kabbi/led-cube-factory/docs/README.md

# the-better-cube docs

Generated by `make docs` from `build/` (run `make all model shapes` first); don't edit by hand.

## Boards

| | Board | LEDs | Pitch | DRC |
|---|---|---|---|---|
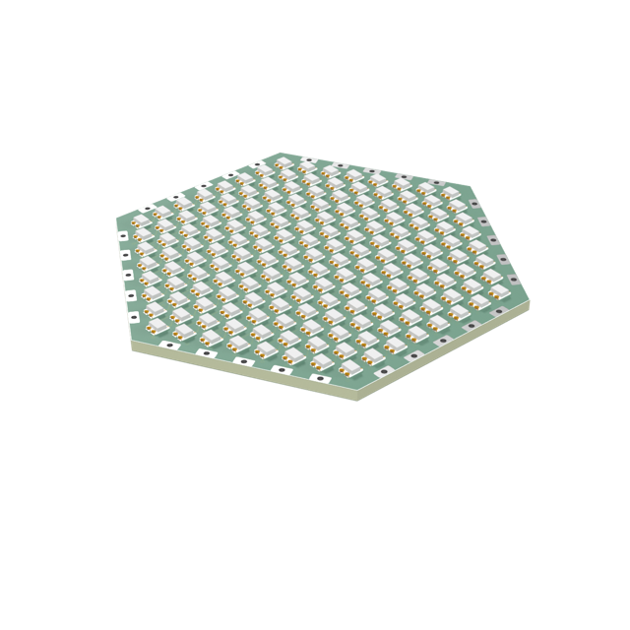
[picture p7: docs/boards/hex30-2020x169-p3.7-pvia/model.png]
|  | [hex30-2020x169-p3.7-pvia](boards/hex30-2020x169-p3.7-pvia/README.md) | 169 | 3.7 mm | 0 errors, 0 warnings, 0 unconnected |
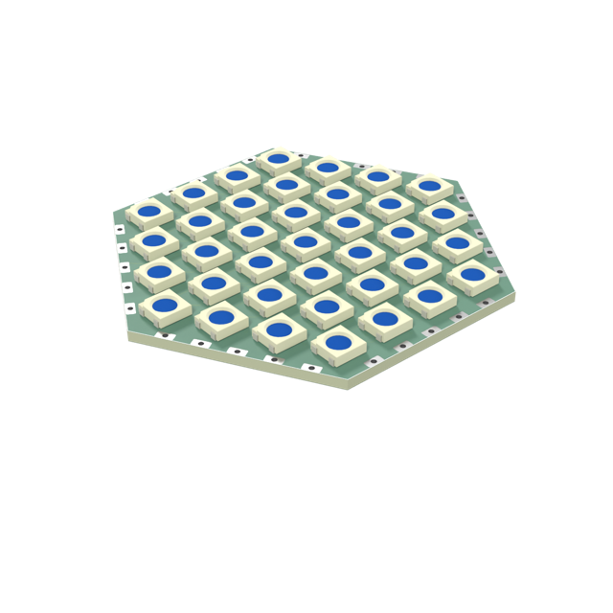
[picture p8: docs/boards/hex30-5050x37-p8-pvia/model.png]
|  | [hex30-5050x37-p8-pvia](boards/hex30-5050x37-p8-pvia/README.md) | 37 | 8 mm | 0 errors, 0 warnings, 0 unconnected |
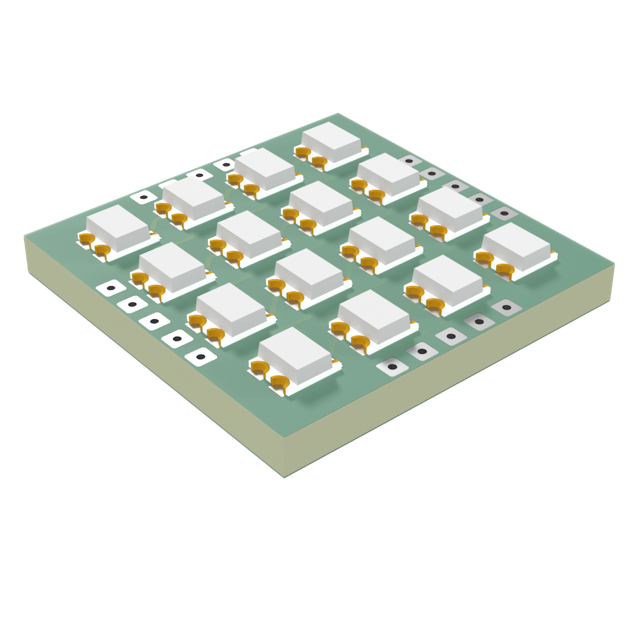
[picture p9: docs/boards/sq15-2020x16-p3.35-micro-pvia/model.png]
|  | [sq15-2020x16-p3.35-micro-pvia](boards/sq15-2020x16-p3.35-micro-pvia/README.md) | 16 | 3.35 mm | 0 errors, 0 warnings, 0 unconnected |
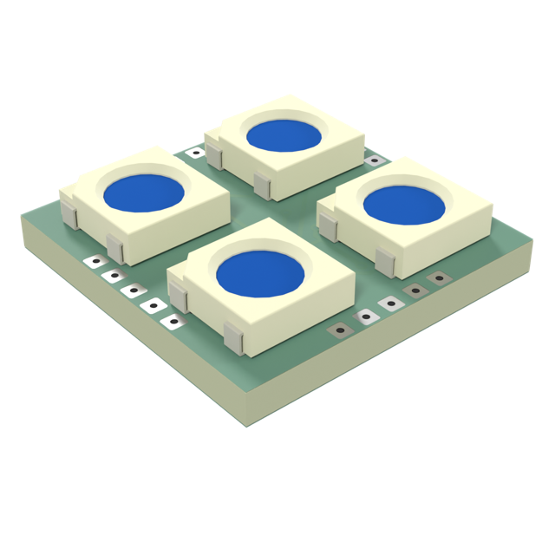
[picture p10: docs/boards/sq15-5050x4-p7.5-micro-pvia/model.png]
|  | [sq15-5050x4-p7.5-micro-pvia](boards/sq15-5050x4-p7.5-micro-pvia/README.md) | 4 | 7.5 mm | 0 errors, 0 warnings, 0 unconnected |
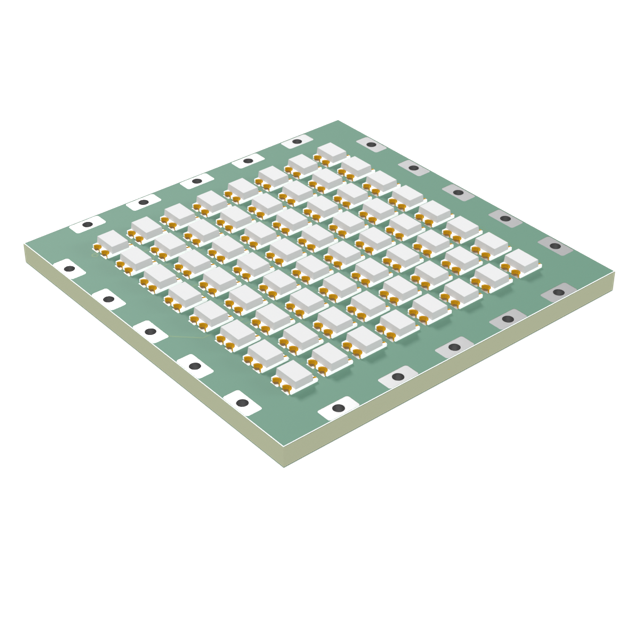
[picture p11: docs/boards/sq30-2020x64-p2.95-pvia/model.png]
|  | [sq30-2020x64-p2.95-pvia](boards/sq30-2020x64-p2.95-pvia/README.md) | 64 | 2.95 mm | 0 errors, 0 warnings, 0 unconnected |
|  | [sq30-2020x64-p3.4-tpl](boards/sq30-2020x64-p3.4-tpl/README.md) | 64 | 3.4 mm | 0 errors, 0 warnings, 0 unconnected |
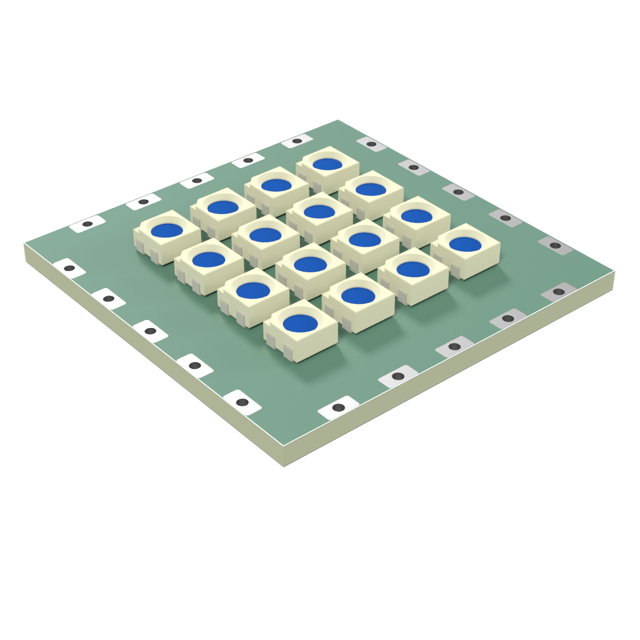
[picture p12: docs/boards/sq30-3535x16-p5-pvia/model.png]
|  | [sq30-3535x16-p5-pvia](boards/sq30-3535x16-p5-pvia/README.md) | 16 | 5 mm | 0 errors, 0 warnings, 0 unconnected |
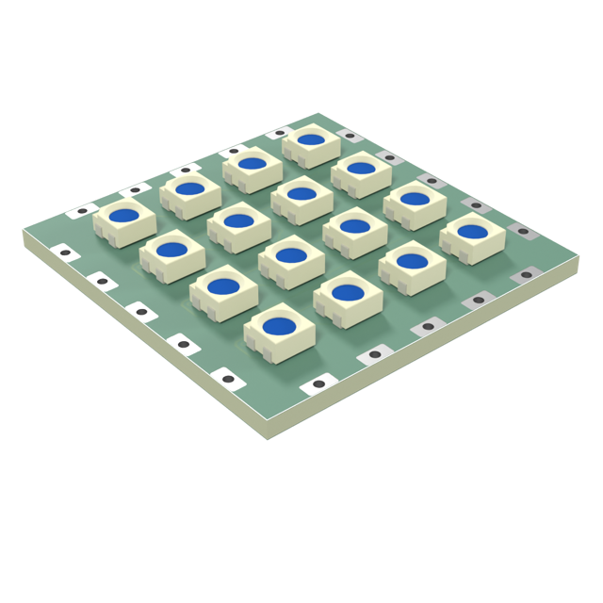
[picture p13: docs/boards/sq30-3535x16-p6.2-pvia/model.png]
|  | [sq30-3535x16-p6.2-pvia](boards/sq30-3535x16-p6.2-pvia/README.md) | 16 | 6.2 mm | 0 errors, 0 warnings, 0 unconnected |
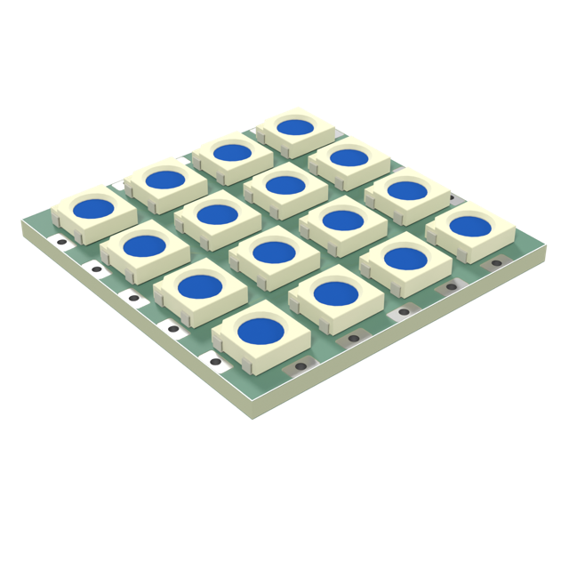
[picture p14: docs/boards/sq30-5050x16-p7.112-tpl/model.png]
|  | [sq30-5050x16-p7.112-tpl](boards/sq30-5050x16-p7.112-tpl/README.md) | 16 | 7.112 mm | 0 errors, 0 warnings, 0 unconnected |
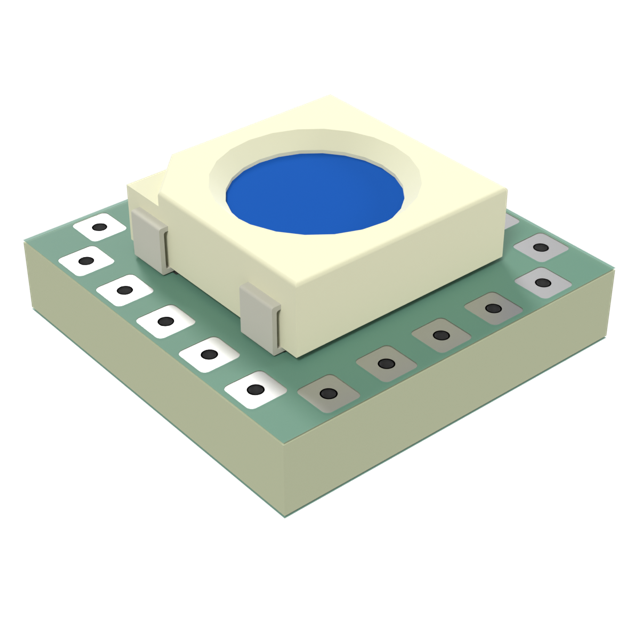
[picture p15: docs/boards/sq8-5050x1-p5.5-micro-grp-nopass-pvia/model.png]
|  | [sq8-5050x1-p5.5-micro-grp-nopass-pvia](boards/sq8-5050x1-p5.5-micro-grp-nopass-pvia/README.md) | 1 | 5.5 mm | 0 errors, 0 warnings, 0 unconnected |
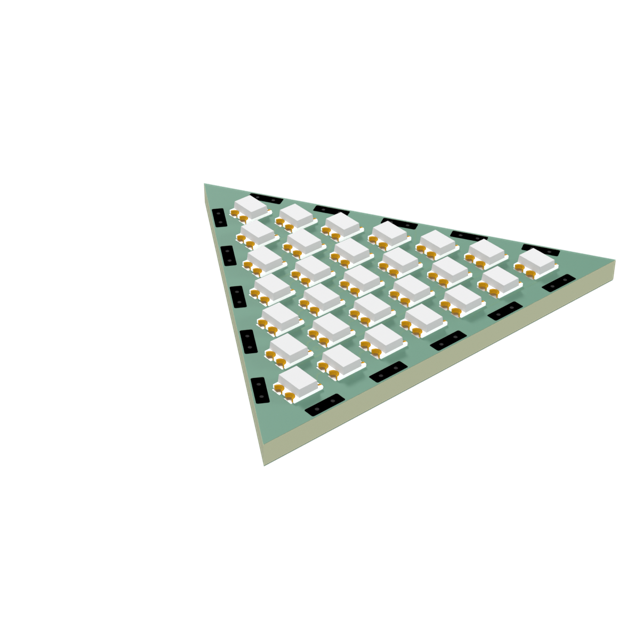
[picture p16: docs/boards/tri30-2020x28-p3.4-shallow-pvia/model.png]
|  | [tri30-2020x28-p3.4-shallow-pvia](boards/tri30-2020x28-p3.4-shallow-pvia/README.md) | 28 | 3.4 mm | 0 errors, 0 warnings, 0 unconnected |
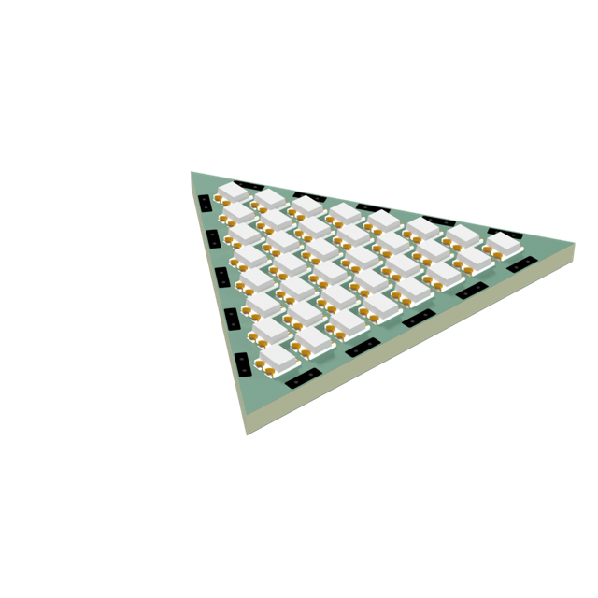
[picture p17: docs/boards/tri30-2020x36-p2.95-shallow-pvia/model.png]
|  | [tri30-2020x36-p2.95-shallow-pvia](boards/tri30-2020x36-p2.95-shallow-pvia/README.md) | 36 | 2.95 mm | 0 errors, 0 warnings, 0 unconnected |
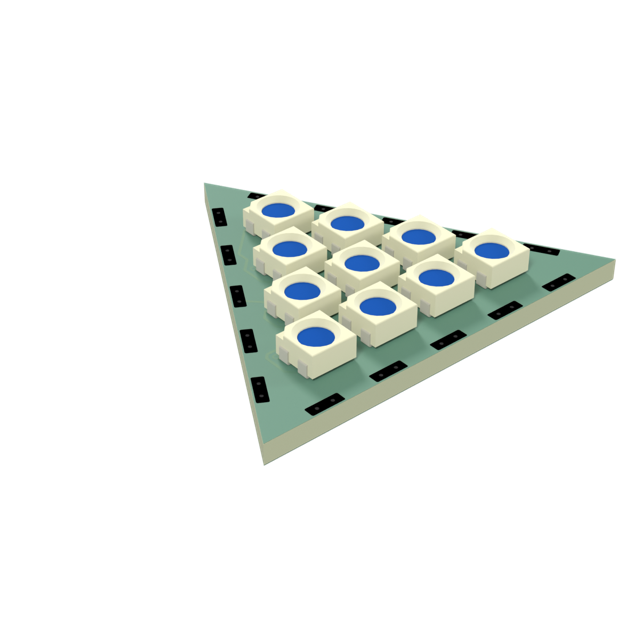
[picture p18: docs/boards/tri30-3535x10-p5-shallow-pvia/model.png]
|  | [tri30-3535x10-p5-shallow-pvia](boards/tri30-3535x10-p5-shallow-pvia/README.md) | 10 | 5 mm | 0 errors, 0 warnings, 0 unconnected |
|  | [tri30-3535x10-p6.2-shallow-rot](boards/tri30-3535x10-p6.2-shallow-rot/README.md) | 10 | 6.2 mm | 0 errors, 0 warnings, 0 unconnected |

## Shapes

| | Shape | LEDs |
|---|---|---|
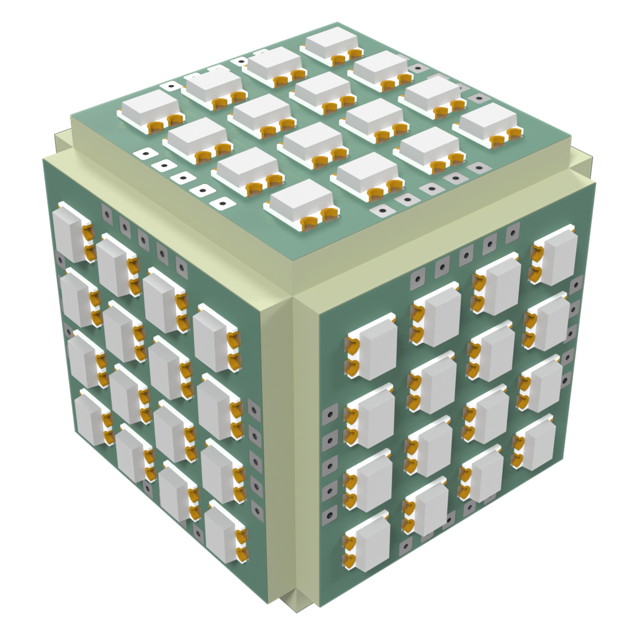
[picture p19: docs/shapes/cube--sq15-2020x16-p3.35-micro-pvia/render.png]
|  | [cube--sq15-2020x16-p3.35-micro-pvia](shapes/cube--sq15-2020x16-p3.35-micro-pvia/README.md) | 96 |
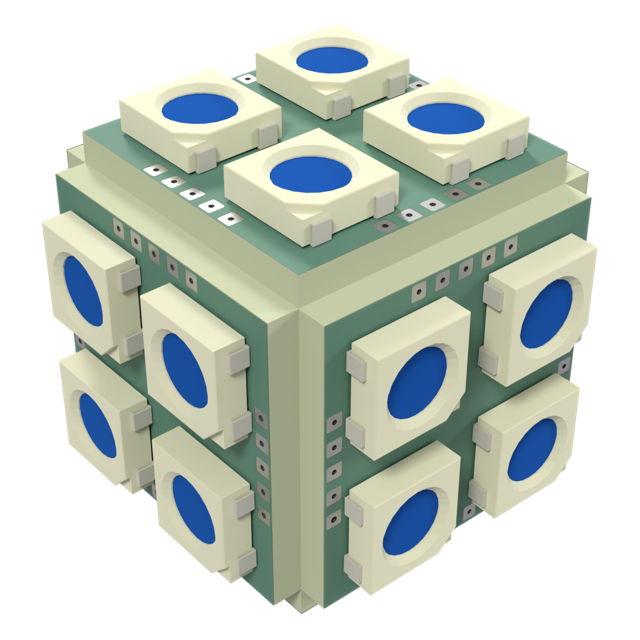
[picture p20: docs/shapes/cube--sq15-5050x4-p7.5-micro-pvia/render.png]
|  | [cube--sq15-5050x4-p7.5-micro-pvia](shapes/cube--sq15-5050x4-p7.5-micro-pvia/README.md) | 24 |
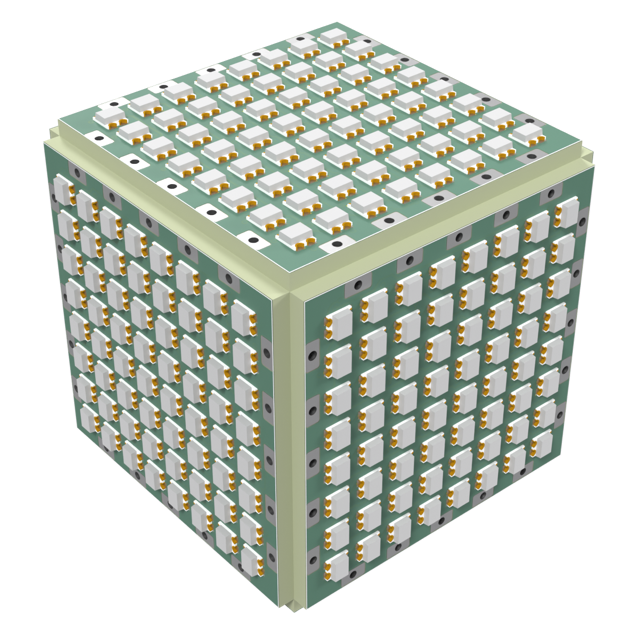
[picture p21: docs/shapes/cube--sq30-2020x64-p3.4-tpl/render.png]
|  | [cube--sq30-2020x64-p3.4-tpl](shapes/cube--sq30-2020x64-p3.4-tpl/README.md) | 384 |
|  | [cube--sq30-3535x16-p6.2-pvia](shapes/cube--sq30-3535x16-p6.2-pvia/README.md) | 96 |
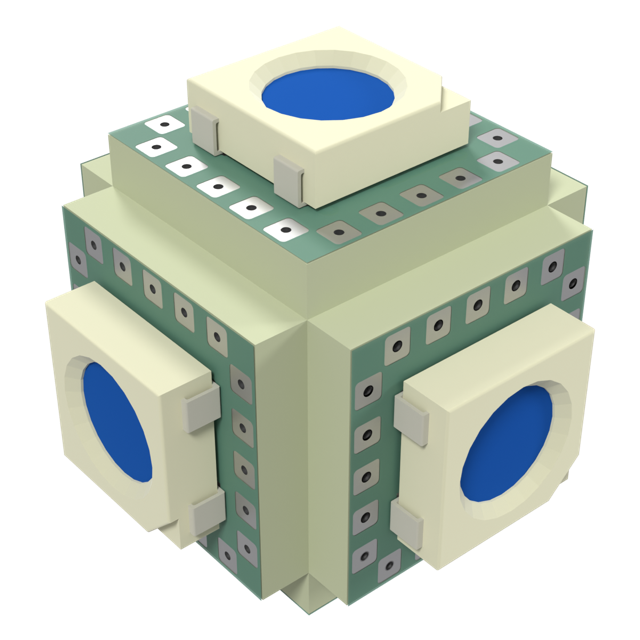
[picture p22: docs/shapes/cube--sq8-5050x1-p5.5-micro-grp-nopass-pvia/render.png]
|  | [cube--sq8-5050x1-p5.5-micro-grp-nopass-pvia](shapes/cube--sq8-5050x1-p5.5-micro-grp-nopass-pvia/README.md) | 6 |
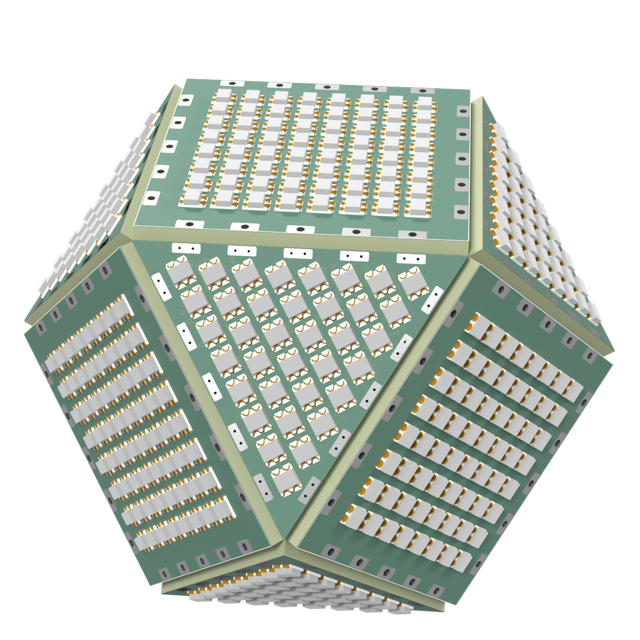
[picture p23: docs/shapes/cuboctahedron--sq30-2020x64-p2.95-pvia+tri30-2020x36-p2.95-shallow-pvia/render.png]
|  | [cuboctahedron--sq30-2020x64-p2.95-pvia+tri30-2020x36-p2.95-shallow-pvia](shapes/cuboctahedron--sq30-2020x64-p2.95-pvia+tri30-2020x36-p2.95-shallow-pvia/README.md) | 672 |
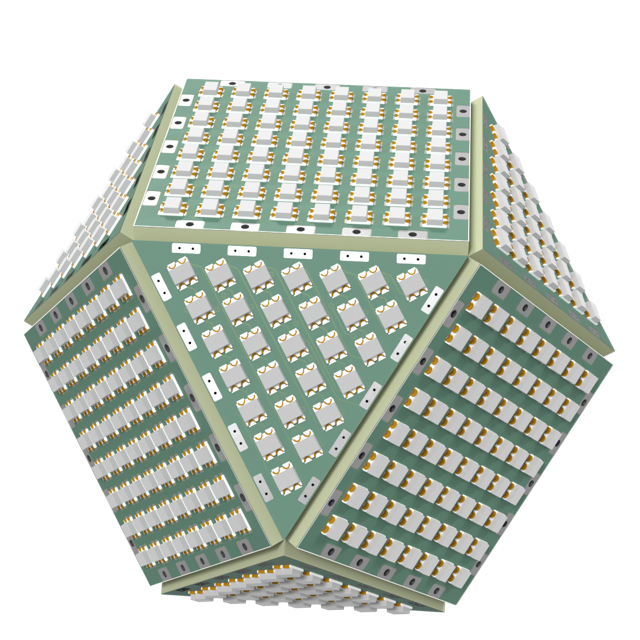
[picture p24: docs/shapes/cuboctahedron--sq30-2020x64-p3.4-tpl+tri30-2020x28-p3.4-shallow-pvia/render.png]
|  | [cuboctahedron--sq30-2020x64-p3.4-tpl+tri30-2020x28-p3.4-shallow-pvia](shapes/cuboctahedron--sq30-2020x64-p3.4-tpl+tri30-2020x28-p3.4-shallow-pvia/README.md) | 608 |
|  | [cuboctahedron--sq30-3535x16-p6.2-pvia+tri30-3535x10-p6.2-shallow-rot](shapes/cuboctahedron--sq30-3535x16-p6.2-pvia+tri30-3535x10-p6.2-shallow-rot/README.md) | 176 |
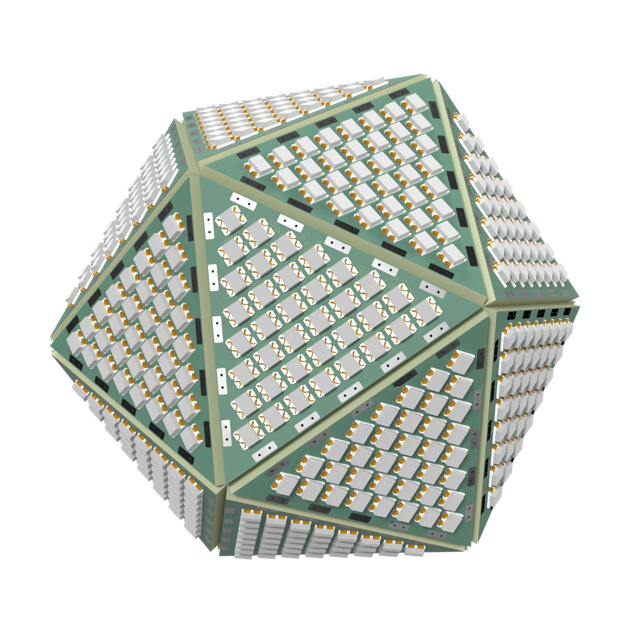
[picture p25: docs/shapes/icosahedron--tri30-2020x36-p2.95-shallow-pvia/render.png]
|  | [icosahedron--tri30-2020x36-p2.95-shallow-pvia](shapes/icosahedron--tri30-2020x36-p2.95-shallow-pvia/README.md) | 720 |
|  | [icosahedron--tri30-3535x10-p6.2-shallow-rot](shapes/icosahedron--tri30-3535x10-p6.2-shallow-rot/README.md) | 200 |
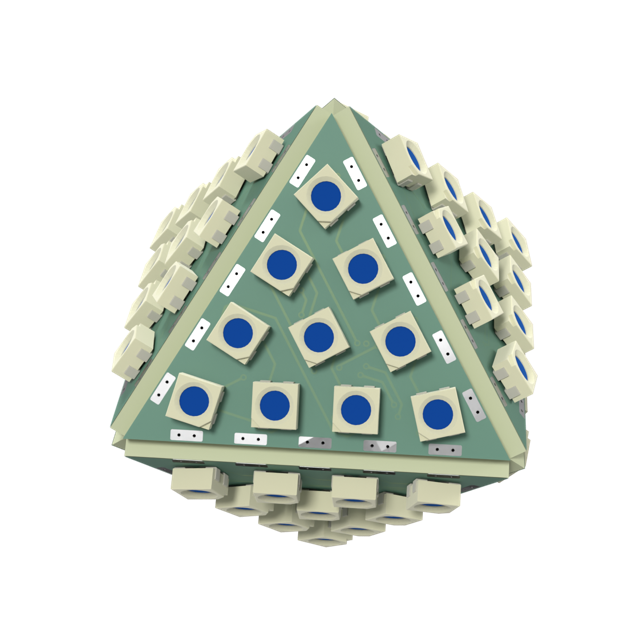
[picture p26: docs/shapes/octahedron--tri30-3535x10-p6.2-shallow-rot/render.png]
|  | [octahedron--tri30-3535x10-p6.2-shallow-rot](shapes/octahedron--tri30-3535x10-p6.2-shallow-rot/README.md) | 80 |
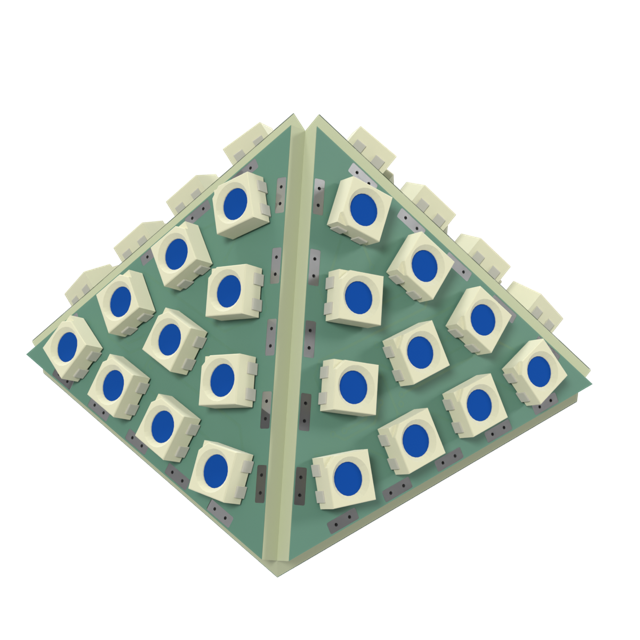
[picture p27: docs/shapes/square-pyramid--sq30-3535x16-p6.2-pvia+tri30-3535x10-p6.2-shallow-rot/render.png]
|  | [square-pyramid--sq30-3535x16-p6.2-pvia+tri30-3535x10-p6.2-shallow-rot](shapes/square-pyramid--sq30-3535x16-p6.2-pvia+tri30-3535x10-p6.2-shallow-rot/README.md) | 56 |
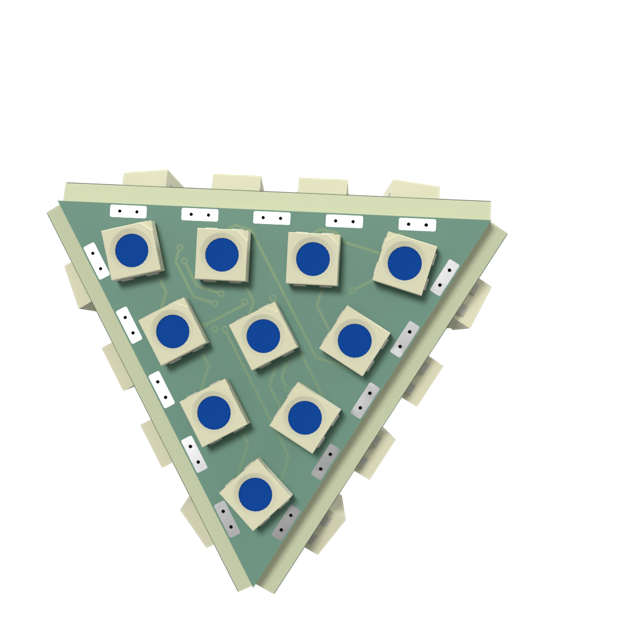
[picture p28: docs/shapes/tetrahedron--tri30-3535x10-p6.2-shallow-rot/render.png]
|  | [tetrahedron--tri30-3535x10-p6.2-shallow-rot](shapes/tetrahedron--tri30-3535x10-p6.2-shallow-rot/README.md) | 40 |
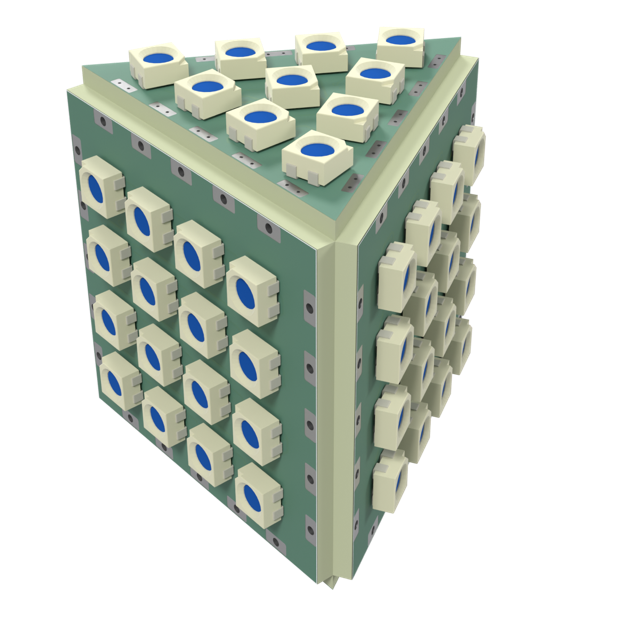
[picture p29: docs/shapes/triangular-prism--sq30-3535x16-p6.2-pvia+tri30-3535x10-p6.2-shallow-rot/render.png]
|  | [triangular-prism--sq30-3535x16-p6.2-pvia+tri30-3535x10-p6.2-shallow-rot](shapes/triangular-prism--sq30-3535x16-p6.2-pvia+tri30-3535x10-p6.2-shallow-rot/README.md) | 68 |
|  | [truncated-octahedron--sq30-2020x64-p3.4-tpl+hex30-2020x169-p3.7-pvia](shapes/truncated-octahedron--sq30-2020x64-p3.4-tpl+hex30-2020x169-p3.7-pvia/README.md) | 1736 |
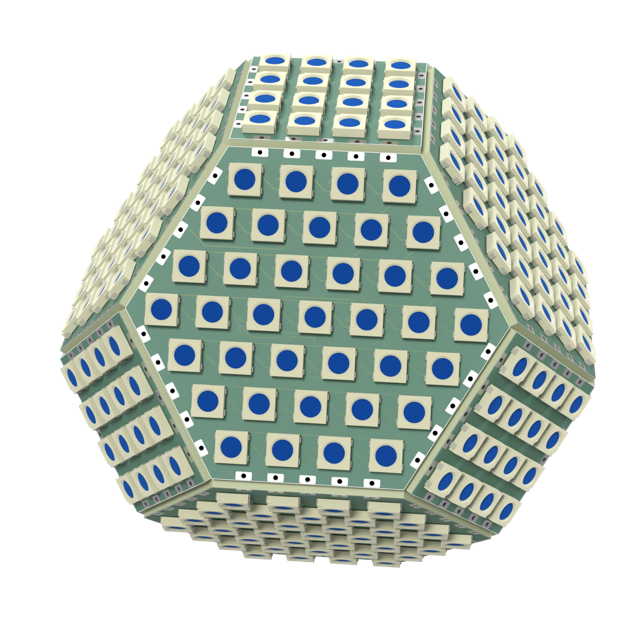
[picture p30: docs/shapes/truncated-octahedron--sq30-5050x16-p7.112-tpl+hex30-5050x37-p8-pvia/render.png]
|  | [truncated-octahedron--sq30-5050x16-p7.112-tpl+hex30-5050x37-p8-pvia](shapes/truncated-octahedron--sq30-5050x16-p7.112-tpl+hex30-5050x37-p8-pvia/README.md) | 392 |
