kabbi/led-cube-factory/docs/boards/sq15-5050x4-p7.5-micro-pvia/README.md

# sq15-5050x4-p7.5-micro-pvia

2x2 WS2812B 5050 on a 15mm square at 7.5mm pitch, half the edge, so the LED grid stays even across tile edges; the widest that keeps the LED bodies 0.3mm from the micro edge connector's pads. (5.5mm, courtyards touching, fits a 13mm edge.)

3D render

## At a glance

| | |
|---|---|
| Shape | square, 15 mm edge, 4 ports |
| LEDs | 4 x WS2812B (2 x 2) |
| Footprint | `tbc:LED_WS2812B_PLCC4_5.0x5.0mm_InnerPads` |
| LCSC | C52917433 |
| Pitch | 7.5 mm |
| Rotation | one rotation, DOUT to the right |
| Chain | raster |
| Edge connector | `edge_connector_micro` (`tbc:edge_conn_micro`) |
| Back side | generated: IN/OUT/PASS jumper hubs with 4 wings each (1.6 mm from the hub centre, hubs on a 3.0 mm circle), 1 cap on P2 |
| Power vias | pattern |
| Router | internal |
| Revision | A |

## Name

| | |
|---|---|
| `sq15` | square, 15 mm edge |
| `5050x4` | 4 LEDs in the 5050 package |
| `p7.5` | 7.5 mm LED pitch |
| `micro` | micro edge connector (small tiles) |
| `pvia` | patterned power vias |

## Build

| | |
|---|---|
| DRC | 0 errors, 0 warnings, 0 unconnected |
| Front track | 52 mm |
| Back track | 58 mm |
| In2 hops | 0 mm |
| Vias | 17 |

## Renders

| Top | Bottom |
|---|---|
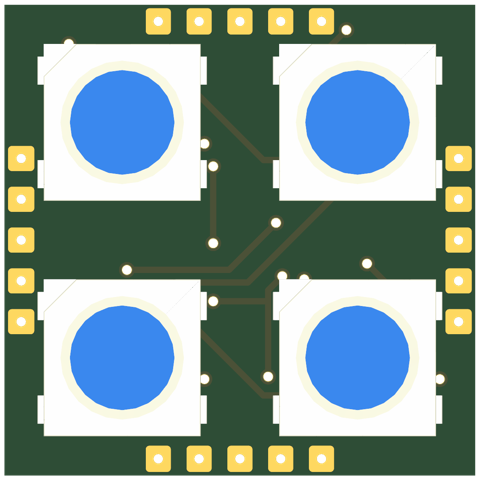
[picture p33: docs/boards/sq15-5050x4-p7.5-micro-pvia/top.png]
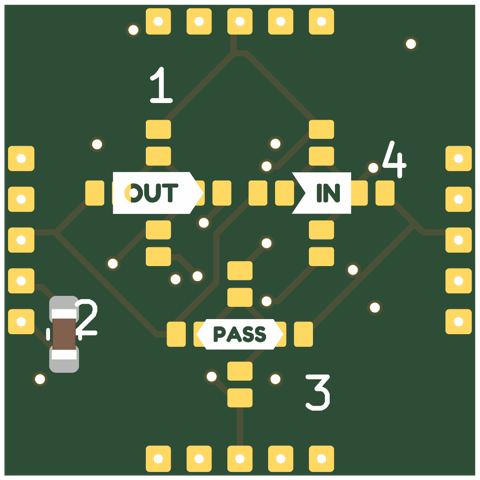
[picture p34: docs/boards/sq15-5050x4-p7.5-micro-pvia/bottom.png]
|  |  |

### Layers

| Front: F.Cu, silkscreen | Back, seen from below: B.Cu, silkscreen |
|---|---|
|  |  |

| In1: GND plane | In2: +5V plane (and a few hops) |
|---|---|
|  |  |

## Pixel map

LED index in the data chain -> position, mm from the board centre (y down, top view). Also in [pixelmap.json](pixelmap.json).

<details><summary>4 LEDs, 4 ports</summary>

| LED | x | y |
|---|---|---|
| 1 | -3.75 | -3.75 |
| 2 | 3.75 | -3.75 |
| 3 | -3.75 | 3.75 |
| 4 | 3.75 | 3.75 |

| Port | x | y | facing |
|---|---|---|---|
| P1 | 0.00 | -7.50 | -90 deg |
| P2 | 7.50 | 0.00 | 0 deg |
| P3 | 0.00 | 7.50 | 90 deg |
| P4 | -7.50 | 0.00 | 180 deg |

</details>

## Used in

- [cube--sq15-5050x4-p7.5-micro-pvia](../../shapes/cube--sq15-5050x4-p7.5-micro-pvia/README.md)

## Files

- config: [boards/sq15-5050x4-p7.5-micro-pvia.yaml](../../../boards/sq15-5050x4-p7.5-micro-pvia.yaml)
- rebuild: `make all model BOARDS=sq15-5050x4-p7.5-micro-pvia && make docs`
- KiCad project, gerbers, BOM/CPL: `build/sq15-5050x4-p7.5-micro-pvia/` (not committed)
