kabbi/led-cube-factory/docs/shapes/cube--sq15-2020x16-p3.35-micro-pvia/README.md

# cube--sq15-2020x16-p3.35-micro-pvia

The small 2020 cube: six 15mm tiles, 4x4 WS2812B-2020 each, 96 LEDs.

render

| | |
|---|---|
| Solid | cube, 6 faces |
| Tiles | 6 x square |
| LEDs | 96 (6 x 16) |
| Size | 20 x 20 x 20 mm (with LEDs) |

## Boards

- **6 x [sq15-2020x16-p3.35-micro-pvia](../../boards/sq15-2020x16-p3.35-micro-pvia/README.md)**: 16 x WS2812B-2020 at 3.35 mm

## Files

- config: [shapes/cube--sq15-2020x16-p3.35-micro-pvia.yaml](../../../shapes/cube--sq15-2020x16-p3.35-micro-pvia.yaml)
- rebuild: `make shapes SHAPES=cube--sq15-2020x16-p3.35-micro-pvia && make docs`
- 3D model: `build/shapes/cube--sq15-2020x16-p3.35-micro-pvia.glb` (not committed; opens in Blender or any glTF viewer)
