kabbi/led-cube-factory/docs/shapes/cube--sq15-5050x4-p7.5-micro-pvia/README.md

# cube--sq15-5050x4-p7.5-micro-pvia

The small 5050 cube: six 15mm tiles, 2x2 WS2812B each, 24 LEDs.

render

| | |
|---|---|
| Solid | cube, 6 faces |
| Tiles | 6 x square |
| LEDs | 24 (6 x 4) |
| Size | 21 x 21 x 21 mm (with LEDs) |

## Boards

- **6 x [sq15-5050x4-p7.5-micro-pvia](../../boards/sq15-5050x4-p7.5-micro-pvia/README.md)**: 4 x WS2812B at 7.5 mm

## Files

- config: [shapes/cube--sq15-5050x4-p7.5-micro-pvia.yaml](../../../shapes/cube--sq15-5050x4-p7.5-micro-pvia.yaml)
- rebuild: `make shapes SHAPES=cube--sq15-5050x4-p7.5-micro-pvia && make docs`
- 3D model: `build/shapes/cube--sq15-5050x4-p7.5-micro-pvia.glb` (not committed; opens in Blender or any glTF viewer)
