kabbi/led-cube-factory/docs/boards/sq15-5050x4-p5.5-micro-pvia/README.md

# sq15-5050x4-p5.5-micro-pvia

2x2 WS2812B 5050 at 5.5mm pitch (courtyards touching) on a 15mm square, with the micro edge connector like the other small tiles. Fits 13mm (the LED bodies 0.3mm from the connector pads); 15mm to match the 4x4 2020.

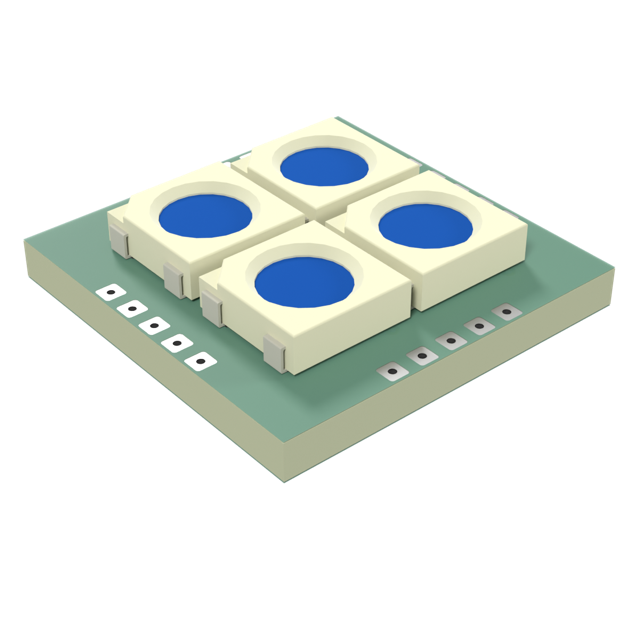
[picture p38: docs/boards/sq15-5050x4-p5.5-micro-pvia/model.png]
3D render


## At a glance

| | |
|---|---|
| Shape | square, 15 mm edge, 4 ports |
| LEDs | 4 x WS2812B (2 x 2) |
| Footprint | `tbc:LED_WS2812B_PLCC4_5.0x5.0mm_InnerPads` |
| LCSC | C52917433 |
| Pitch | 5.5 mm |
| Rotation | one rotation, DOUT to the right |
| Chain | raster |
| Edge connector | `edge_connector_micro` (`tbc:edge_conn_micro`) |
| Back side | generated: IN/OUT/PASS jumper hubs with 4 wings each (1.6 mm from the hub centre, hubs on a 3.0 mm circle), 1 cap on P2 |
| Power vias | pattern |
| Router | internal |
| Revision | A |

## Name

| | |
|---|---|
| `sq15` | square, 15 mm edge |
| `5050x4` | 4 LEDs in the 5050 package |
| `p5.5` | 5.5 mm LED pitch |
| `micro` | micro edge connector (small tiles) |
| `pvia` | patterned power vias |

## Build

| | |
|---|---|
| DRC | 0 errors, 0 warnings, 0 unconnected |
| Front track | 44 mm |
| Back track | 66 mm |
| In2 hops | 0 mm |
| Vias | 18 |

## Renders

| Top | Bottom |
|---|---|
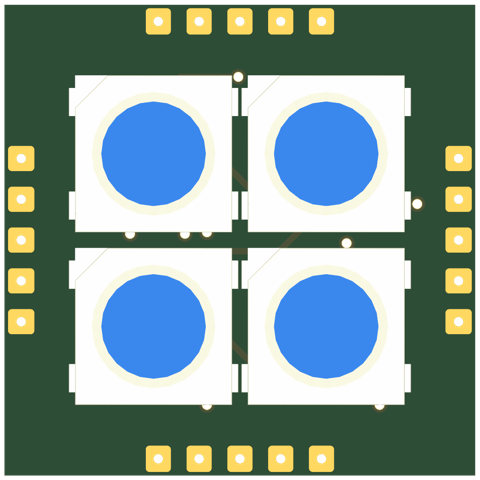
[picture p39: docs/boards/sq15-5050x4-p5.5-micro-pvia/top.png]
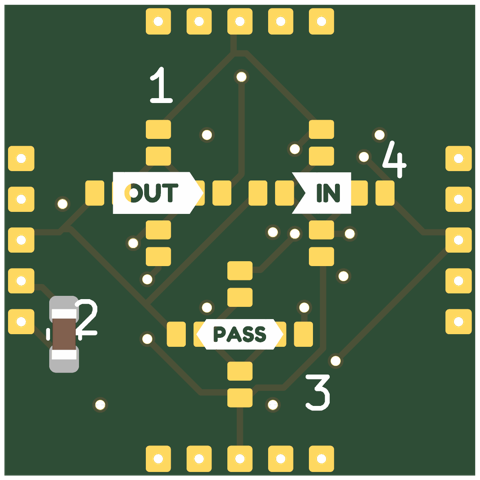
[picture p40: docs/boards/sq15-5050x4-p5.5-micro-pvia/bottom.png]
|  |  |

### Layers

| Front: F.Cu, silkscreen | Back, seen from below: B.Cu, silkscreen |
|---|---|
|  |  |

| In1: GND plane | In2: +5V plane (and a few hops) |
|---|---|
|  |  |

## Pixel map

LED index in the data chain -> position, mm from the board centre (y down, top view). Also in [pixelmap.json](pixelmap.json).

<details><summary>4 LEDs, 4 ports</summary>

| LED | x | y |
|---|---|---|
| 1 | -2.75 | -2.75 |
| 2 | 2.75 | -2.75 |
| 3 | -2.75 | 2.75 |
| 4 | 2.75 | 2.75 |

| Port | x | y | facing |
|---|---|---|---|
| P1 | 0.00 | -7.50 | -90 deg |
| P2 | 7.50 | 0.00 | 0 deg |
| P3 | 0.00 | 7.50 | 90 deg |
| P4 | -7.50 | 0.00 | 180 deg |

</details>

## Used in

- [cube--sq15-5050x4-p5.5-micro-pvia](../../shapes/cube--sq15-5050x4-p5.5-micro-pvia/README.md)

## Files

- config: [boards/sq15-5050x4-p5.5-micro-pvia.yaml](../../../boards/sq15-5050x4-p5.5-micro-pvia.yaml)
- rebuild: `make all model BOARDS=sq15-5050x4-p5.5-micro-pvia && make docs`
- KiCad project, gerbers, BOM/CPL: `build/sq15-5050x4-p5.5-micro-pvia/` (not committed)
