kabbi/led-cube-factory/docs/shapes/cube--sq8-5050x1-p5.5-micro-grp-nopass-pvia/README.md

# cube--sq8-5050x1-p5.5-micro-grp-nopass-pvia

The 6-LED cube: six 8mm micro tiles, one WS2812B each, IN/OUT jumpers only.

render

| | |
|---|---|
| Solid | cube, 6 faces |
| Tiles | 6 x square |
| LEDs | 6 (6 x 1) |
| Size | 14 x 14 x 14 mm (with LEDs) |

## Boards

- **6 x [sq8-5050x1-p5.5-micro-grp-nopass-pvia](../../boards/sq8-5050x1-p5.5-micro-grp-nopass-pvia/README.md)**: 1 x WS2812B at 5.5 mm

## Files

- config: [shapes/cube--sq8-5050x1-p5.5-micro-grp-nopass-pvia.yaml](../../../shapes/cube--sq8-5050x1-p5.5-micro-grp-nopass-pvia.yaml)
- rebuild: `make shapes SHAPES=cube--sq8-5050x1-p5.5-micro-grp-nopass-pvia && make docs`
- 3D model: `build/shapes/cube--sq8-5050x1-p5.5-micro-grp-nopass-pvia.glb` (not committed; opens in Blender or any glTF viewer)
