kabbi/led-cube-factory/docs/boards/hex30-2020x169-p3.7-pvia/README.md

# hex30-2020x169-p3.7-pvia

Hexagon tile, 8 rings (169) of WS2812B-2020 at 3.7mm pitch: the LED density of the 8x8 sq30-2020x64-p3.4-tpl (0.072/mm2), and 3.7mm is about the widest 8 rings go (0.6mm from the pads to the connector pads; 3.75 leaves 0.3). 9 rings (217) would need 3.3mm and doesn't route: six ports to three hubs take In2 crossings, and a 3.3-3.4mm field has no room for their vias.

3D render

## At a glance

| | |
|---|---|
| Shape | hexagon, 30 mm edge, 6 ports |
| LEDs | 169 x WS2812B-2020 (8 rings) |
| Footprint | `tbc:LED_WS2812B-2020_PLCC4_2.0x2.0mm` |
| LCSC | C52917434 |
| Pitch | 3.7 mm |
| Rotation | one rotation, DOUT to the right |
| Chain | raster |
| Edge connector | `edge_connector` (`tbc:edge_conn`) |
| Back side | generated: IN/OUT/PASS jumper hubs with 6 wings each (4.3 mm from the hub centre, hubs on a 8.0 mm circle), 2 caps per edge |
| Power vias | pattern |
| Router | internal |
| Revision | A |

## Name

| | |
|---|---|
| `hex30` | hexagon, 30 mm edge |
| `2020x169` | 169 LEDs in the 2020 package |
| `p3.7` | 3.7 mm LED pitch |
| `pvia` | patterned power vias |

## Build

| | |
|---|---|
| DRC | 0 errors, 0 warnings, 0 unconnected |
| Front track | 1223 mm |
| Back track | 409 mm |
| In2 hops | 13.7 mm |
| Vias | 369 |

## Renders

| Top | Bottom |
|---|---|
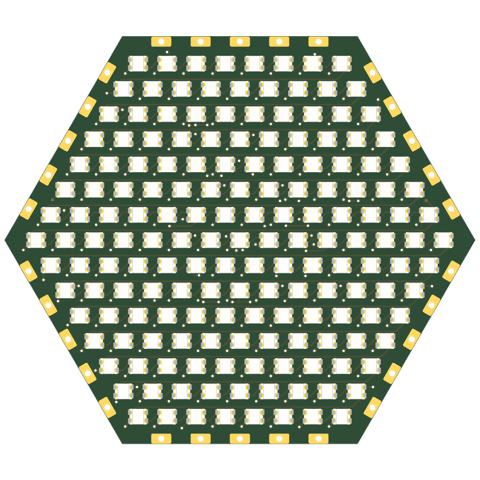
[picture p43: docs/boards/hex30-2020x169-p3.7-pvia/top.png]
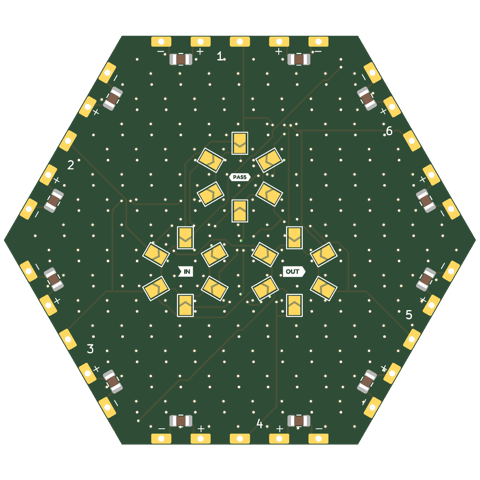
[picture p44: docs/boards/hex30-2020x169-p3.7-pvia/bottom.png]
|  |  |

### Layers

| Front: F.Cu, silkscreen | Back, seen from below: B.Cu, silkscreen |
|---|---|
|  |  |

| In1: GND plane | In2: +5V plane (and a few hops) |
|---|---|
|  |  |

## Pixel map

LED index in the data chain -> position, mm from the board centre (y down, top view). Also in [pixelmap.json](pixelmap.json).

<details><summary>169 LEDs, 6 ports</summary>

| LED | x | y |
|---|---|---|
| 1 | -12.95 | -22.43 |
| 2 | -9.25 | -22.43 |
| 3 | -5.55 | -22.43 |
| 4 | -1.85 | -22.43 |
| 5 | 1.85 | -22.43 |
| 6 | 5.55 | -22.43 |
| 7 | 9.25 | -22.43 |
| 8 | 12.95 | -22.43 |
| 9 | -14.80 | -19.23 |
| 10 | -11.10 | -19.23 |
| 11 | -7.40 | -19.23 |
| 12 | -3.70 | -19.23 |
| 13 | 0.00 | -19.23 |
| 14 | 3.70 | -19.23 |
| 15 | 7.40 | -19.23 |
| 16 | 11.10 | -19.23 |
| 17 | 14.80 | -19.23 |
| 18 | -16.65 | -16.02 |
| 19 | -12.95 | -16.02 |
| 20 | -9.25 | -16.02 |
| 21 | -5.55 | -16.02 |
| 22 | -1.85 | -16.02 |
| 23 | 1.85 | -16.02 |
| 24 | 5.55 | -16.02 |
| 25 | 9.25 | -16.02 |
| 26 | 12.95 | -16.02 |
| 27 | 16.65 | -16.02 |
| 28 | -18.50 | -12.82 |
| 29 | -14.80 | -12.82 |
| 30 | -11.10 | -12.82 |
| 31 | -7.40 | -12.82 |
| 32 | -3.70 | -12.82 |
| 33 | 0.00 | -12.82 |
| 34 | 3.70 | -12.82 |
| 35 | 7.40 | -12.82 |
| 36 | 11.10 | -12.82 |
| 37 | 14.80 | -12.82 |
| 38 | 18.50 | -12.82 |
| 39 | -20.35 | -9.61 |
| 40 | -16.65 | -9.61 |
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

| Port | x | y | facing |
|---|---|---|---|
| P1 | -0.00 | -25.98 | -90 deg |
| P2 | 22.50 | -12.99 | -30 deg |
| P3 | 22.50 | 12.99 | 30 deg |
| P4 | 0.00 | 25.98 | 90 deg |
| P5 | -22.50 | 12.99 | 150 deg |
| P6 | -22.50 | -12.99 | -150 deg |

</details>

## Used in

- [truncated-octahedron--sq30-2020x64-p3.4-tpl+hex30-2020x169-p3.7-pvia](../../shapes/truncated-octahedron--sq30-2020x64-p3.4-tpl+hex30-2020x169-p3.7-pvia/README.md)

## Files

- config: [boards/hex30-2020x169-p3.7-pvia.yaml](../../../boards/hex30-2020x169-p3.7-pvia.yaml)
- rebuild: `make all model BOARDS=hex30-2020x169-p3.7-pvia && make docs`
- KiCad project, gerbers, BOM/CPL: `build/hex30-2020x169-p3.7-pvia/` (not committed)
