kabbi/led-cube-factory/docs/shapes/icosahedron--tri30-2020x36-p2.95-shallow-pvia/README.md

# icosahedron--tri30-2020x36-p2.95-shallow-pvia

The dense icosahedron: twenty 36-LED 2020 triangles, 720 LEDs.

render

| | |
|---|---|
| Solid | icosahedron, 20 faces |
| Tiles | 20 x triangle |
| LEDs | 720 (20 x 36) |
| Size | 52 x 52 x 52 mm (with LEDs) |

## Boards

- **20 x [tri30-2020x36-p2.95-shallow-pvia](../../boards/tri30-2020x36-p2.95-shallow-pvia/README.md)**: 36 x WS2812B-2020 at 2.95 mm

## Files

- config: [shapes/icosahedron--tri30-2020x36-p2.95-shallow-pvia.yaml](../../../shapes/icosahedron--tri30-2020x36-p2.95-shallow-pvia.yaml)
- rebuild: `make shapes SHAPES=icosahedron--tri30-2020x36-p2.95-shallow-pvia && make docs`
- 3D model: `build/shapes/icosahedron--tri30-2020x36-p2.95-shallow-pvia.glb` (not committed; opens in Blender or any glTF viewer)
