kabbi/led-cube-factory/docs/shapes/cube--sq30-2020x64-p3.4-tpl/README.md

# cube--sq30-2020x64-p3.4-tpl

The dense cube: six 8x8 2020 tiles on the hand-drawn dense back, 384 LEDs.

render

| | |
|---|---|
| Solid | cube, 6 faces |
| Tiles | 6 x square |
| LEDs | 384 (6 x 64) |
| Size | 35 x 35 x 35 mm (with LEDs) |

## Boards

- **6 x [sq30-2020x64-p3.4-tpl](../../boards/sq30-2020x64-p3.4-tpl/README.md)**: 64 x WS2812B-2020 at 3.4 mm

## Files

- config: [shapes/cube--sq30-2020x64-p3.4-tpl.yaml](../../../shapes/cube--sq30-2020x64-p3.4-tpl.yaml)
- rebuild: `make shapes SHAPES=cube--sq30-2020x64-p3.4-tpl && make docs`
- 3D model: `build/shapes/cube--sq30-2020x64-p3.4-tpl.glb` (not committed; opens in Blender or any glTF viewer)
