kabbi/led-cube-factory/docs/shapes/cube--sq30-3535x16-p6.2-pvia/README.md

# cube--sq30-3535x16-p6.2-pvia

The 3535 cube, 96 LEDs at the same 6.2mm pitch as the triangles.

render

| | |
|---|---|
| Solid | cube, 6 faces |
| Tiles | 6 x square |
| LEDs | 96 (6 x 16) |
| Size | 37 x 37 x 37 mm (with LEDs) |

## Boards

- **6 x [sq30-3535x16-p6.2-pvia](../../boards/sq30-3535x16-p6.2-pvia/README.md)**: 16 x WS2812B-Mini at 6.2 mm

## Files

- config: [shapes/cube--sq30-3535x16-p6.2-pvia.yaml](../../../shapes/cube--sq30-3535x16-p6.2-pvia.yaml)
- rebuild: `make shapes SHAPES=cube--sq30-3535x16-p6.2-pvia && make docs`
- 3D model: `build/shapes/cube--sq30-3535x16-p6.2-pvia.glb` (not committed; opens in Blender or any glTF viewer)
