kabbi/led-cube-factory/docs/shapes/icosahedron--tri30-3535x10-p6.2-shallow-rot/README.md

# icosahedron--tri30-3535x10-p6.2-shallow-rot

Twenty triangles, 200 LEDs: the roundest all-triangle shape.

render

| | |
|---|---|
| Solid | icosahedron, 20 faces |
| Tiles | 20 x triangle |
| LEDs | 200 (20 x 10) |
| Size | 54 x 54 x 54 mm (with LEDs) |

## Boards

- **20 x [tri30-3535x10-p6.2-shallow-rot](../../boards/tri30-3535x10-p6.2-shallow-rot/README.md)**: 10 x WS2812B-Mini at 6.2 mm

## Files

- config: [shapes/icosahedron--tri30-3535x10-p6.2-shallow-rot.yaml](../../../shapes/icosahedron--tri30-3535x10-p6.2-shallow-rot.yaml)
- rebuild: `make shapes SHAPES=icosahedron--tri30-3535x10-p6.2-shallow-rot && make docs`
- 3D model: `build/shapes/icosahedron--tri30-3535x10-p6.2-shallow-rot.glb` (not committed; opens in Blender or any glTF viewer)
