kabbi/led-cube-factory/docs/shapes/octahedron--tri30-3535x10-p6.2-shallow-rot/README.md

# octahedron--tri30-3535x10-p6.2-shallow-rot

Eight triangles, 80 LEDs.

render

| | |
|---|---|
| Solid | octahedron, 8 faces |
| Tiles | 8 x triangle |
| LEDs | 80 (8 x 10) |
| Size | 44 x 44 x 44 mm (with LEDs) |

## Boards

- **8 x [tri30-3535x10-p6.2-shallow-rot](../../boards/tri30-3535x10-p6.2-shallow-rot/README.md)**: 10 x WS2812B-Mini at 6.2 mm

## Files

- config: [shapes/octahedron--tri30-3535x10-p6.2-shallow-rot.yaml](../../../shapes/octahedron--tri30-3535x10-p6.2-shallow-rot.yaml)
- rebuild: `make shapes SHAPES=octahedron--tri30-3535x10-p6.2-shallow-rot && make docs`
- 3D model: `build/shapes/octahedron--tri30-3535x10-p6.2-shallow-rot.glb` (not committed; opens in Blender or any glTF viewer)
