kabbi/led-cube-factory/docs/shapes/tetrahedron--tri30-3535x10-p6.2-shallow-rot/README.md

# tetrahedron--tri30-3535x10-p6.2-shallow-rot

Four triangles: the smallest closed shape, 40 LEDs.

render

| | |
|---|---|
| Solid | tetrahedron, 4 faces |
| Tiles | 4 x triangle |
| LEDs | 40 (4 x 10) |
| Size | 23 x 23 x 23 mm (with LEDs) |

## Boards

- **4 x [tri30-3535x10-p6.2-shallow-rot](../../boards/tri30-3535x10-p6.2-shallow-rot/README.md)**: 10 x WS2812B-Mini at 6.2 mm

## Files

- config: [shapes/tetrahedron--tri30-3535x10-p6.2-shallow-rot.yaml](../../../shapes/tetrahedron--tri30-3535x10-p6.2-shallow-rot.yaml)
- rebuild: `make shapes SHAPES=tetrahedron--tri30-3535x10-p6.2-shallow-rot && make docs`
- 3D model: `build/shapes/tetrahedron--tri30-3535x10-p6.2-shallow-rot.glb` (not committed; opens in Blender or any glTF viewer)
