kabbi/led-cube-factory/experiments/README.md

# Experiments

One page per experiment: the question, what was tried, the numbers, and what
came out of it. The main [README](../README.md) only describes how things
work now. Name new pages `YYYY-MM-DD-<topic>.md` and add a row here.

| date | experiment | outcome |
|---|---|---|
| 2026-10-16 | [Triangle on the 30 mm edge](2026-10-16-triangle-3535.md) | shallow connector, inner-pad 3535, 5 mm pitch pair |
| 2026-10-16 | [LED rotation on triangles](2026-10-16-led-rotation.md) | `rotation: edge`, 6.2 mm pitch pair |
| 2026-10-16 | [Freerouting vs the in-house router](2026-10-16-freerouting.md) | in-house router stays the default |
| 2026-10-16 | [Power-via placement](2026-10-16-power-via-placement.md) | `power_vias: pattern`; dense 8x8 routes without a template |
| 2026-10-16 | [Dense 2020 pair](2026-10-16-dense-2020-pair.md) | 2.95 mm (8/side) and 3.4 mm (7 rows) on JLC-minimum rules |
| 2026-10-16 | [Hexagon tiles](2026-10-16-hexagons.md) | 37 x 5050 at 8 mm, 169 x 2020 at 3.7 mm |
| 2026-10-18 | [Smallest 2x2 5050](2026-10-18-small-2x2-5050.md) | 13 mm possible; built at 15 mm, 7.5 mm pitch |
| 2026-10-18 | [Smallest 4x4 2020](2026-10-18-small-4x4-2020.md) | 13.5 mm possible; built at 15 mm, 3.35 mm pitch |
| 2026-10-18 | [Smallest 1x1 5050](2026-10-18-small-1x1-5050.md) | 8 mm with grouped jumpers, no PASS |
| 2026-10-21 | [V-cut panels vs tabs](2026-10-21-vcut-panels.md) | squares on V-cuts, triangles/hexagons on tabs |
