kabbi/led-cube-factory/(commit log)

2026-10-16 Parametric LED tile generator: square and triangle boards, demo shapes, docs
    - tbcgen: KiCad 10 boards from one YAML per variant (hand-drawn template
    backs or generated ones with IN/OUT/PASS jumper hubs), DRC, renders,
    JLC fab files, KiKit panels
    - boards: 30 mm squares (5050, 2020, 3535) and triangles (3535) with
    shallow edge-connector pads and per-LED edge rotation; file names are
    derived from the config and checked on load
    - shapes: polyhedra assembled from board GLBs, PNG previews via headless
    Blender
    - docs/: generated page per board and per shape
2026-10-16 README: gallery of shape and board renders, link to the docs
2026-10-16 Dense 2020 pair: 36-LED triangle and 8x8 square at 2.95mm pitch
    tri30-2020x36-p2.95-shallow-pvia and sq30-2020x64-p2.95-pvia share LED,
    pitch and LEDs per side (8). The triangle's pads set the pitch: 8 rows fit
    up to ~2.97mm with clearance to the shallow connector pads.
    To route at 0.42mm pad gaps:
    - per-board rules 0.127/0.1 track/clearance, 0.2 via hole to copper
    (JLC multilayer minimums)
    - new hole_copper_clearance rule (was hardcoded 0.25); the router paints
    vias bigger so hole-to-copper holds when clearance is finer
    - 2020 courtyard trimmed to pads + 0.15mm (was wider than the pitch)
    - square hub layout turned 180 so P4 gets through
    Also: cuboctahedron (672 LEDs) and icosahedron (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
2026-10-16 7-row 2020 triangle at 3.4mm, matching the 8x8 dense square
    tri30-2020x28-p3.4-shallow-pvia: 7+6+...+1 WS2812B-2020 at the pitch of
    sq30-2020x64-p3.4-tpl. Default rules leave a port boxed in on the back
    (or need hubs so tight the jumpers collide); the dense pair's rules route
    with 54/56 vias patterned. Cuboctahedron demo with the 8x8, 608 LEDs.
2026-10-16 Panels: mixed boards, nested triangles, tabs only by the corners
    panels/<name>.yaml places built boards on one KiKit panel: grid, or rows
    of triangles alternating apex up/down with slanted edges nested 2mm apart.
    Four panels: 3x2 of the 2020 and 3535 squares, 2x5 of the 3535 triangle,
    and one of each triangle variant, all within 100 x 100 mm on 5mm rails.
    Connector pads fill the middle of every edge, so tabs sit in the ~3.7mm
    next to each corner (measured per board). Mousebite cuts are read off the
    panel as milled, so fillets and corner junctions the cutter can't reach
    are perforated too; a joint reaching copper fails the build. A mixed
    panel takes its DRC rules from the board with the fine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
2026-10-16 Docs: rebuild every board with the plane fills as saved by check
    The inner planes now keep the 0.3mm edge clearance in the saved board
    (and so in the in1/in2 renders and gerbers) instead of running to the
    board edge. A fresh make all also re-routes: a few boards' track lengths
    and via counts shift slightly, all still DRC clean.
2026-10-16 Hexagon tiles: 37 x 5050 at 8mm and 169 x 2020 at 3.7mm
    hex30-5050x37-p8-pvia: 4 rings, the most 5050s a 30mm hexagon takes;
    8mm is the widest pitch that keeps 0.4mm from the corner LEDs' bodies to
    the connector pads. hex30-2020x169-p3.7-pvia: 8 rings at the 8x8 square's
    LED density, 0.6mm to the pads. Both generated backs, DRC clean.
    9 rings of 2020 (217, 3.3mm) and 8 rings at 3.4mm don't route: six ports
    on three hubs make a K3,6 on the back, and the crossings need In2 hop vias
    the dense field has no room for. Experiments in the README.
    - router: prepare shapes in Grid._window (~40x faster on board-sized
    polygons; the hex corridor masks took minutes each)
    - models: hexagonal prism, tru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
2026-10-16 Edge connector: drop the short silk lines at the pad row ends
    The 3mm lines perpendicular to the edge blended into a square's outline,
    fell off a triangle's, but drew arrows at every hexagon vertex. The line
    along the edge stays. Rebuilt the five generated boards using edge_conn
    (both hexes, the 2.95mm 8x8, both 3535 squares), all DRC clean, with their
    models, shapes and docs.
2026-10-18 Mini tile: 2x2 5050 on a 13mm square
    Mini edge connector (shallow pads at 2.2mm pitch, 10.2mm span), a small
    solder jumper, and caps.ports to put caps on some edges only.
2026-10-18 Mini tile: 4x4 2020 on a 13.5mm square, and a cube of each mini tile
2026-10-18 Small tiles: 15mm 2x2 5050 and 4x4 2020, 8mm 1x1 5050, one micro connector
    - edge_connector_micro (pads 0.8mm at 1.3mm pitch, 6mm span, solid to the
    planes) replaces the mini one; all three small tiles use it
    - 2x2 5050 and 4x4 2020 grown to 15mm to match (fit 13 / 13.5mm); the
    2020's hubs re-swept for 15mm
    - 1x1 5050 on 8mm: grouped jumpers (hubs.layout: grouped, an IN/OUT pair
    along each edge, hub nets routed as rings), no PASS hub (hubs.roles),
    no cap
    - shape test: a shape's boards share one edge length (was: 30mm only)
    - cube shapes for all three
2026-10-18 Small tiles: widest pitch on the 15mm ones
    - 2x2 5050 at 7.5mm (half the edge: an even grid across tile edges)
    - 4x4 2020 at 3.35mm, on default rules (vias now fit between pad rows)
2026-10-21 Panels: V-cuts for the squares, micro tiles on two V-cut panels
    - layout vcut: squares edge to edge in bands (each column one tile width,
    each row one tile height, `.` cells are scrap), V-cuts on every band
    boundary and against the rails; preset jlc-vcut; `legend:` for short
    board keys in a panel's rows
    - sq15-micro-mix-24: 12 x 2x2 5050 + 12 x 4x4 2020, 90 x 70 mm
    - sq8-5050x1-p5.5-micro-grp-nopass-pvia-11x6: 66 x 1x1, 88 x 58 mm (its
    1mm of free edge by the corners can't take a tab and its mill fillet)
    - both sq30 3x2 panels on V-cuts: 90 x 70 mm, no tabs, no nubs
    - panel DRC waives solder mask bridges between two boards' pads (they merge
    across the cut line on the dense template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
